jweers1/Aprs-Tracker/Schematic/APRS-Tracker_schem.png

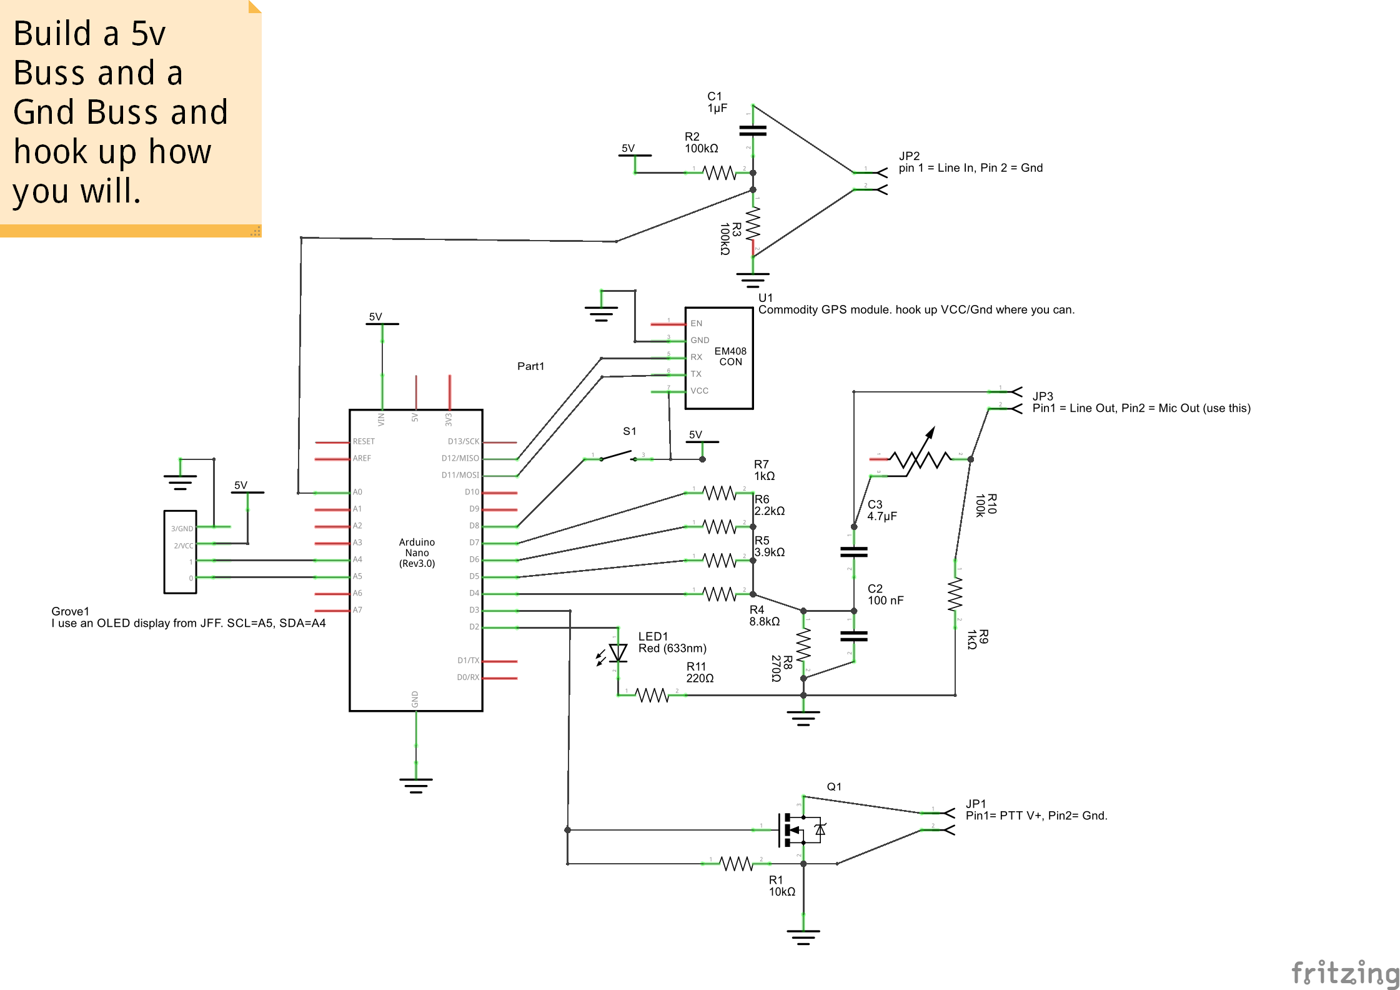
Schematic/APRS-Tracker_schem.png
