jweers1/Aprs-Tracker/(list of files, drawings)

Other design files:
Schematic/APRS-Tracker.fzz
