jweers1/Aprs-Tracker/(commit log)

2015-04-15 Nearly Production
    Nearly Production version. notes and schematic are uploaded as well
    as the code.
    [APRS-Tracker.fzz]
2015-04-16 v1.0
    added speed adjustments to the circuit so it will back the frequency
    down as you go faster.
2015-04-16 1.1
    clean up the routing in fritzing so it has at least a possibility of
    being fabbed correctly. DRC still doesn't succeed, so more routing
    work to be done.
    [APRS-Tracker.fzz]
